amar2g/ece198/hardware_setup.png

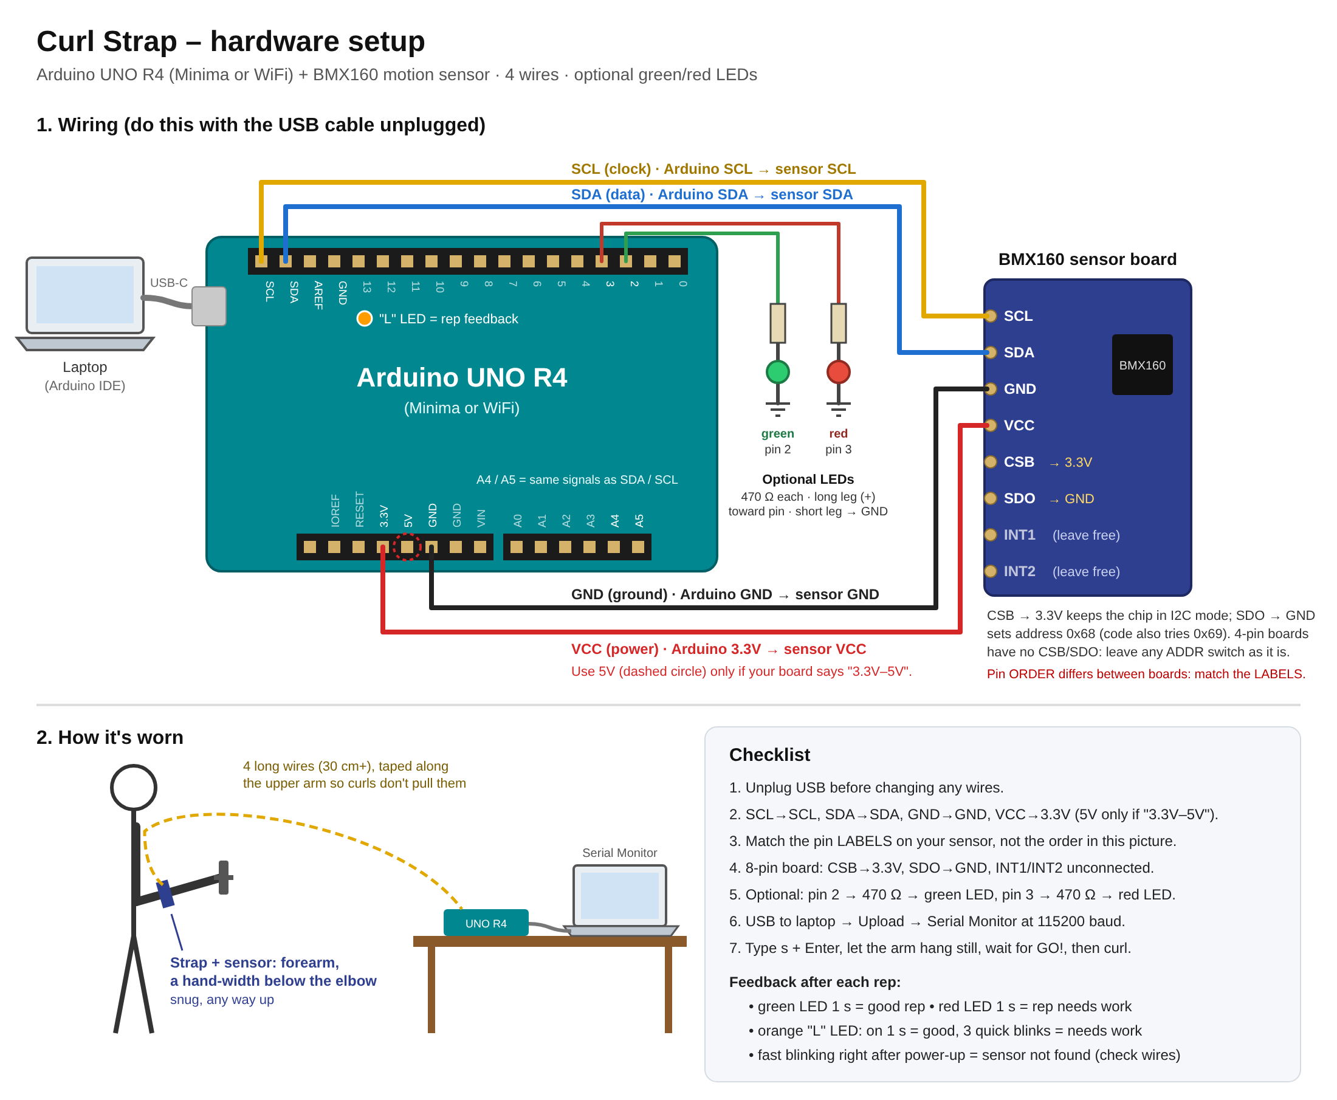
hardware_setup.png
